hotchk155/midi_nubbin/docs/pcb.png

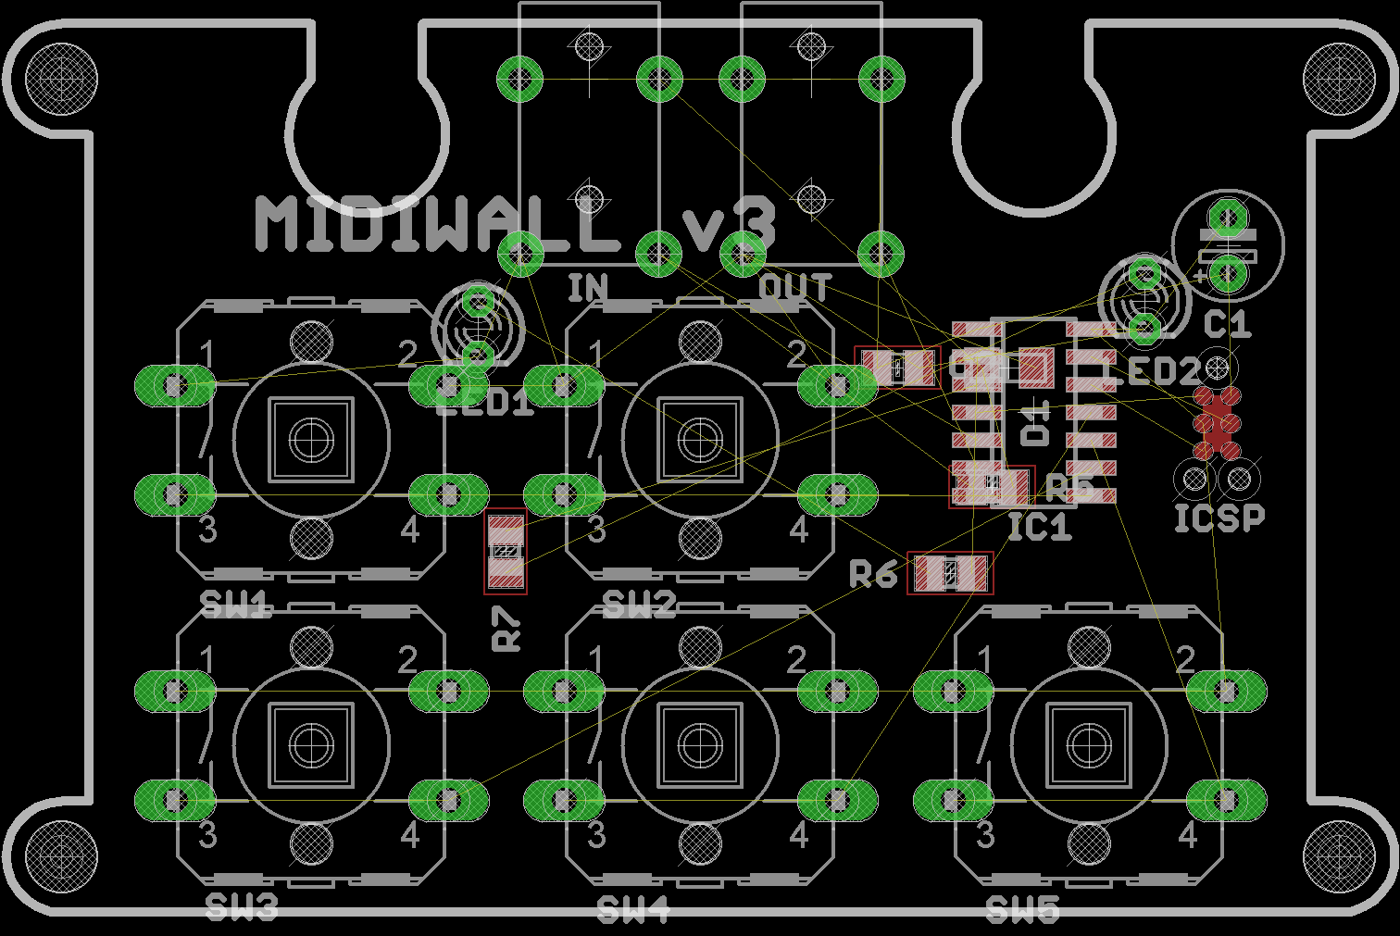
docs/pcb.png
