hotchk155/midi_nubbin/fascia/clock-fascia.png

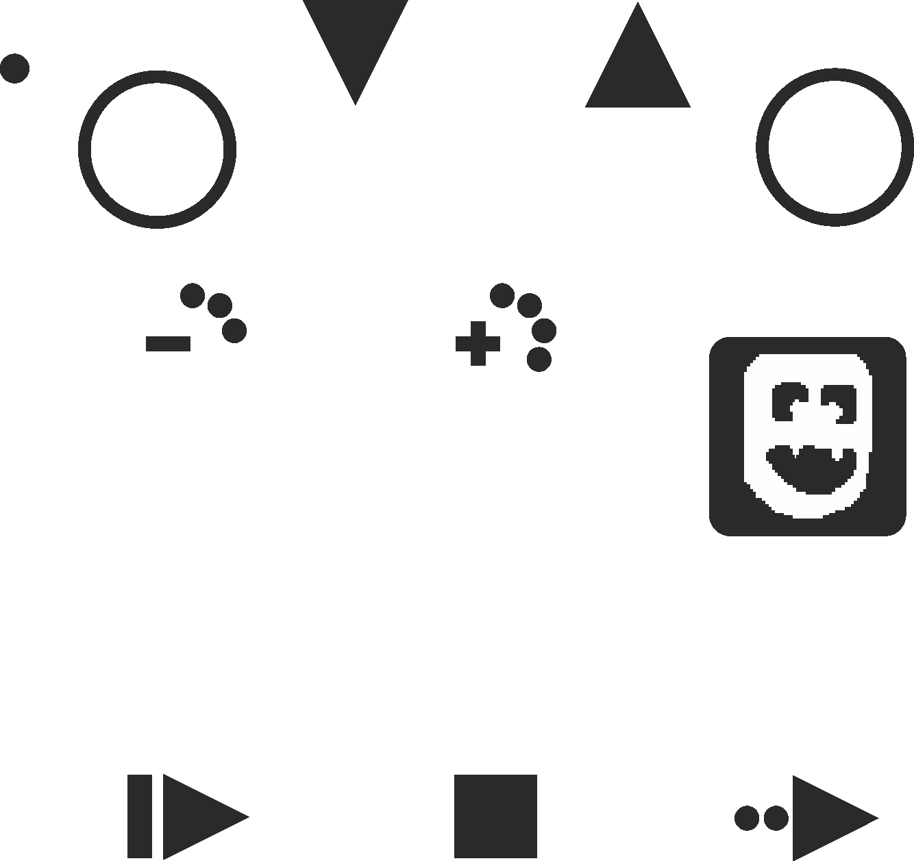
fascia/clock-fascia.png
