hotchk155/midi_nubbin/docs/MIDI Nubbin BOM.xlsx

Reflow
C1 | 10u | Tantalum Cap SMCB
C2 | 100n | Ceramic Cap 0805
D1, D2 | Blue LED | LED 0805
IC1 | PIC16F15345-I/SS | Microcontroller TSSOP20
R1, R6 | 1K | 0805 Resistor
R2, R4, R5 | 220R | 0805 Resistor
R3 | 4k7 | 0805 Resistor
Manually soldered
5 OFF | DTSM-65N-V-B | 6x6x9.5mm Tact Switch SMT
2 OFF | LUMBERG 1503 02 | Stereo 3.5mm jack SMT
8 | m3 x 6mm x 5 dia head flat head machine screw ultra low profile
5 | switch hat white
4 | 6mm f/f hex standoff
1 | white 3mm acrylic 40x48mm
1 | pcb front panel
2 | light guides 3mm dia x 4mm long
1 | 5mm EVA foam 40 x 48mm
1 | cut adhesive neoprene pad 40x48mm
1 | velcro hook pad 25x25mm
