hotchk155/midi_nubbin/hardware/midi_nubbin.brd

## EAGLE design hardware/midi_nubbin.brd (2023-05-03)

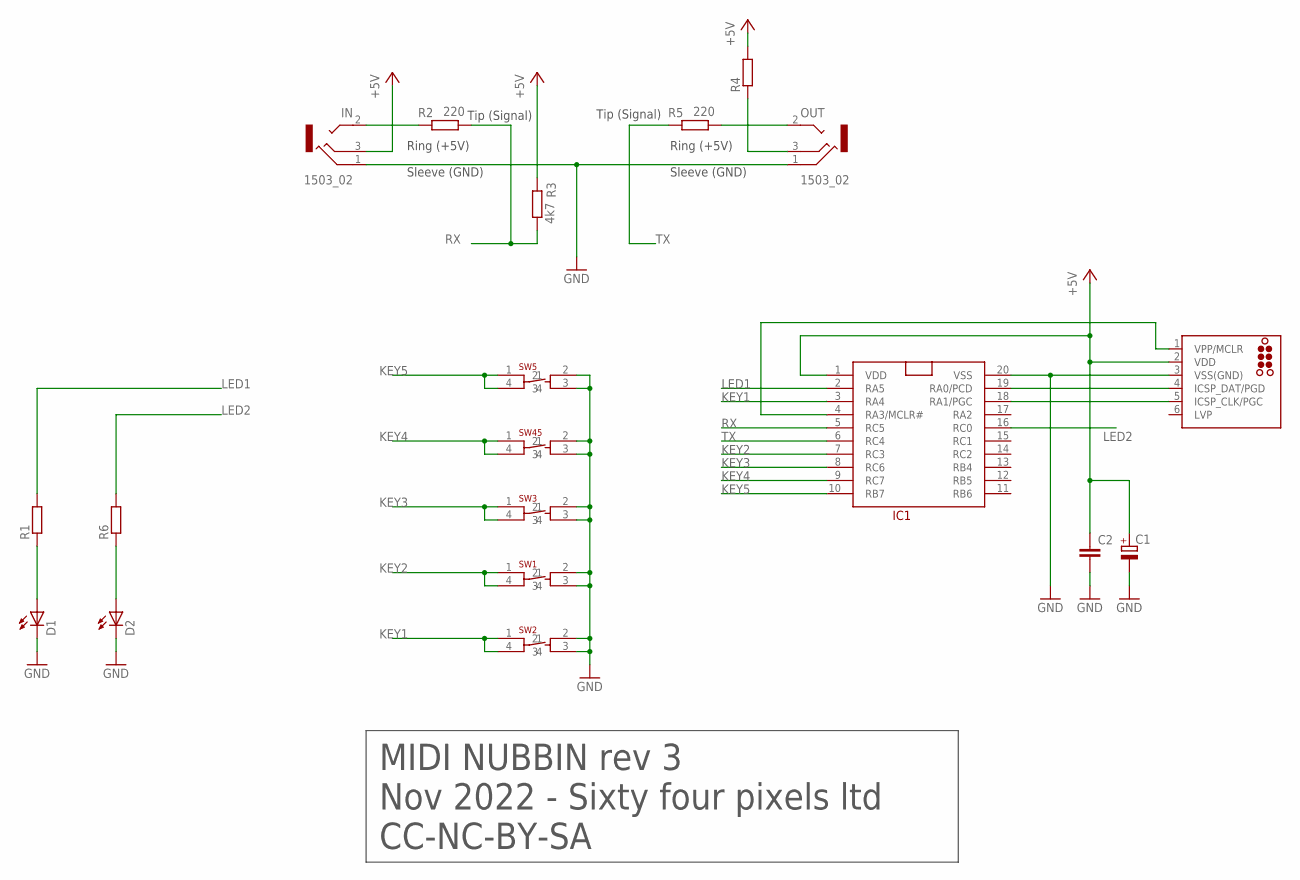
[picture p3: schematic midi_nubbin.sch]

Parts:
C1: CPOL-EUSMCB; SMC_B
C2: C-EUC0805; C0805
D1, D2: LEDCHIPLED_0805; CHIPLED_0805
IC1: PIC16F15345SSOP20; SSOP20
ICSP: TC2030-MCP-NL
IN: 1503_02
OUT: 1503_02
R1, R4, R6: R-EU_R0805; R0805
R2, R5: 220; R0805
R3: 4k7; R0805
SW1, SW2, SW3, SW5, SW45: 6MMTACTSMT

Connections:
+5V: C1.+, C2.1, IC1.1 (VDD), ICSP.2 (VDD), IN.3, R3.2, R4.2
GND: C1.-, C2.2, D1.C, D2.C, IC1.20 (VSS), ICSP.3 (VSS(GND)), IN.1, OUT.1, SW1.2, SW1.3, SW2.2, SW2.3, SW3.2, SW3.3, SW5.2, SW5.3, SW45.2, SW45.3
KEY1: IC1.3 (RA4), SW2.1, SW2.4
KEY2: IC1.7 (RC3), SW1.1, SW1.4
KEY3: IC1.8 (RC6), SW3.1, SW3.4
KEY4: IC1.9 (RC7), SW45.1, SW45.4
KEY5: IC1.10 (RB7), SW5.1, SW5.4
LED1: IC1.2 (RA5), R1.2
LED2: IC1.16 (RC0), R6.2
unnamed: D1.A, R1.1
unnamed: D2.A, R6.1
unnamed: OUT.3, R4.1
unnamed: OUT.2, R5.1
unnamed: IN.2, R2.2
PGC: IC1.18 (RA1/PGC), ICSP.5 (ICSP_CLK/PGC)
PGD: IC1.19 (RA0/PCD), ICSP.4 (ICSP_DAT/PGD)
RX: IC1.5 (RC5), R2.1, R3.1
TX: IC1.6 (RC4), R5.2
VPP: IC1.4 (RA3/MCLR#), ICSP.1 (VPP/MCLR)

Notes on the sheet:
MIDI NUBBIN rev 3
Nov 2022 - Sixty four pixels ltd
CC-NC-BY-SA
Tip (Signal)
Ring (+5V)
Sleeve (GND)

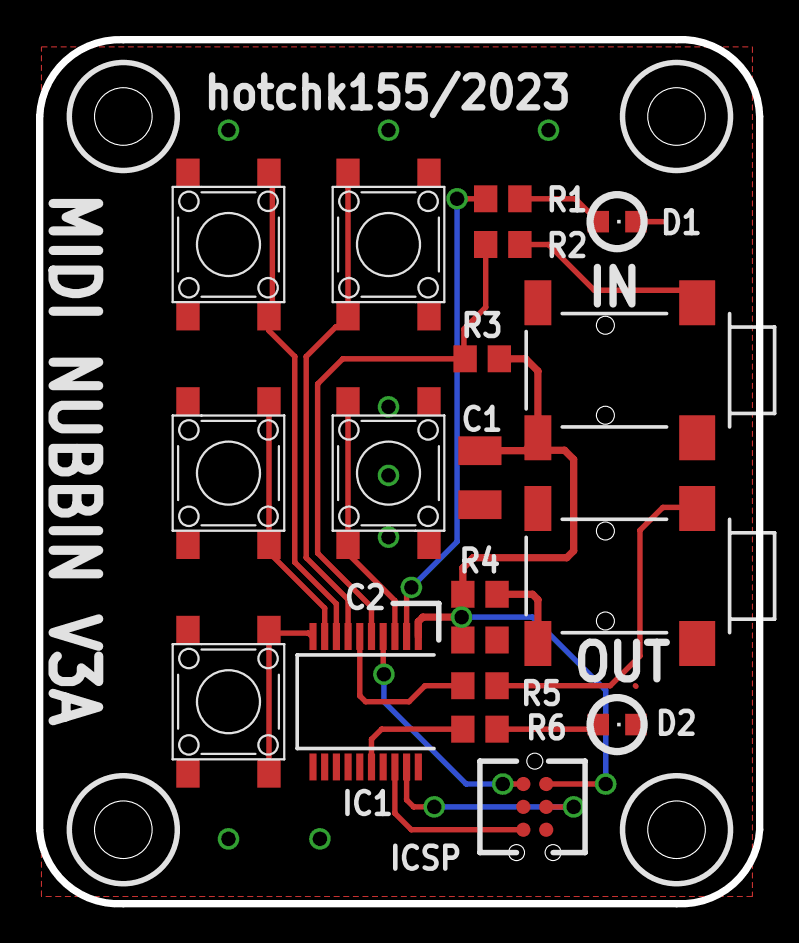
[picture p4: board midi_nubbin.brd from above]

Board: 2 copper layers, 40.0 x 48.0 mm, 19 parts (0 on the bottom side), 19 nets.
