hotchk155/midi_nubbin/hardware/midiwall.brd

## EAGLE design hardware/midiwall.brd (2022-04-05)

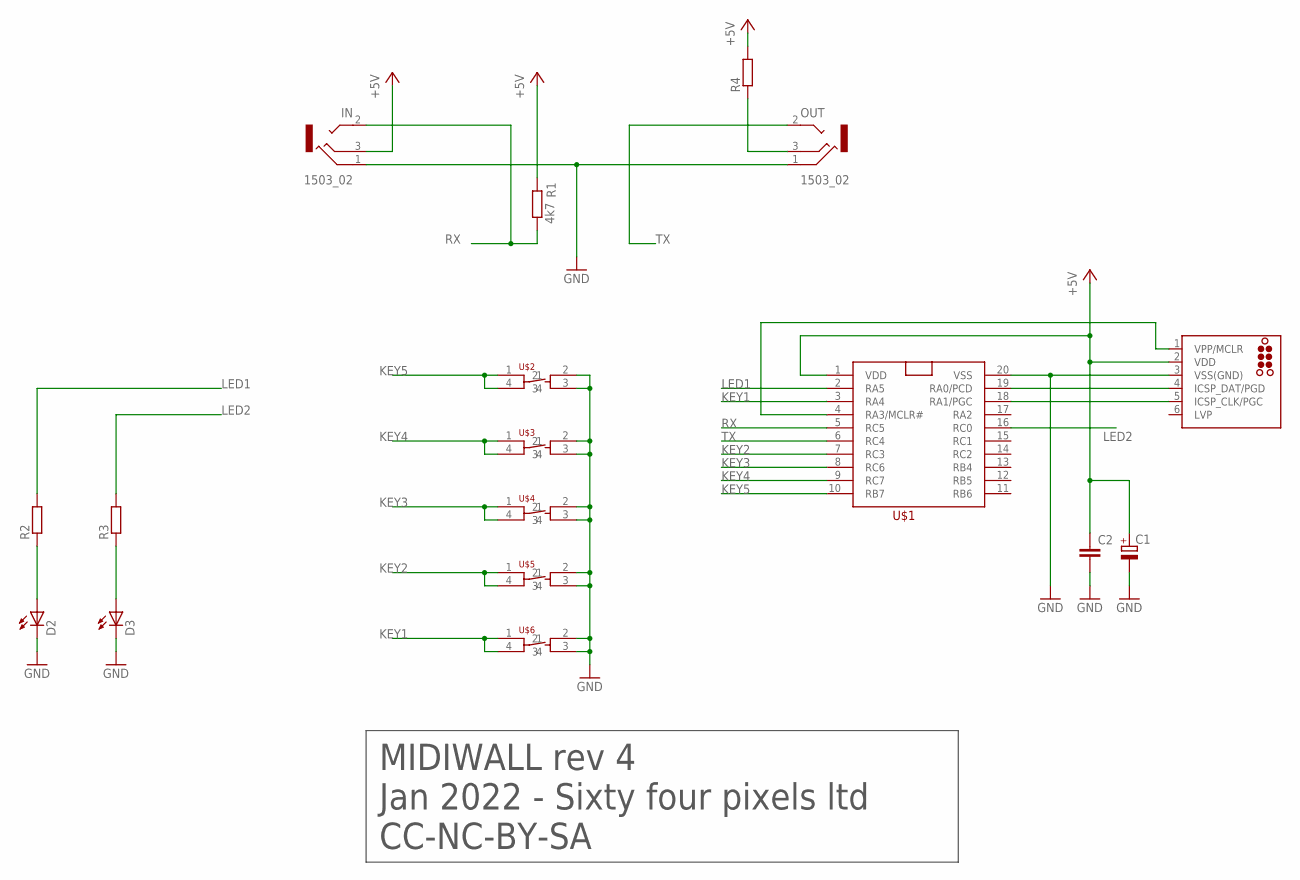
[picture p5: schematic midiwall.sch]

Parts:
C1: CPOL-EUSMCB; SMC_B
C2: C-EUC0805; C0805
D2, D3: LEDCHIPLED_0805; CHIPLED_0805
ICSP: TC2030-MCP-NL
IN: 1503_02
OUT: 1503_02
R1: 4k7; R0805
R2, R3, R4: R-EU_R0805; R0805
U$1: PIC16F15345; TSSOP20
U$2, U$3, U$4, U$5, U$6: 6MMTACTSMT

Connections:
+5V: C1.+, C2.1, ICSP.2 (VDD), IN.3, R1.2, R4.2, U$1.1 (VDD)
GND: C1.-, C2.2, D2.C, D3.C, ICSP.3 (VSS(GND)), IN.1, OUT.1, U$1.20 (VSS), U$2.2, U$2.3, U$3.2, U$3.3, U$4.2, U$4.3, U$5.2, U$5.3, U$6.2, U$6.3
KEY1: U$1.3 (RA4), U$6.1, U$6.4
KEY2: U$1.7 (RC3), U$5.1, U$5.4
KEY3: U$1.8 (RC6), U$4.1, U$4.4
KEY4: U$1.9 (RC7), U$3.1, U$3.4
KEY5: U$1.10 (RB7), U$2.1, U$2.4
LED1: R2.2, U$1.2 (RA5)
LED2: R3.2, U$1.16 (RC0)
unnamed: D2.A, R2.1
unnamed: D3.A, R3.1
unnamed: OUT.3, R4.1
PGC: ICSP.5 (ICSP_CLK/PGC), U$1.18 (RA1/PGC)
PGD: ICSP.4 (ICSP_DAT/PGD), U$1.19 (RA0/PCD)
RX: IN.2, R1.1, U$1.5 (RC5)
TX: OUT.2, U$1.6 (RC4)
VPP: ICSP.1 (VPP/MCLR), U$1.4 (RA3/MCLR#)

Notes on the sheet:
MIDIWALL rev 4
Jan 2022 - Sixty four pixels ltd
CC-NC-BY-SA

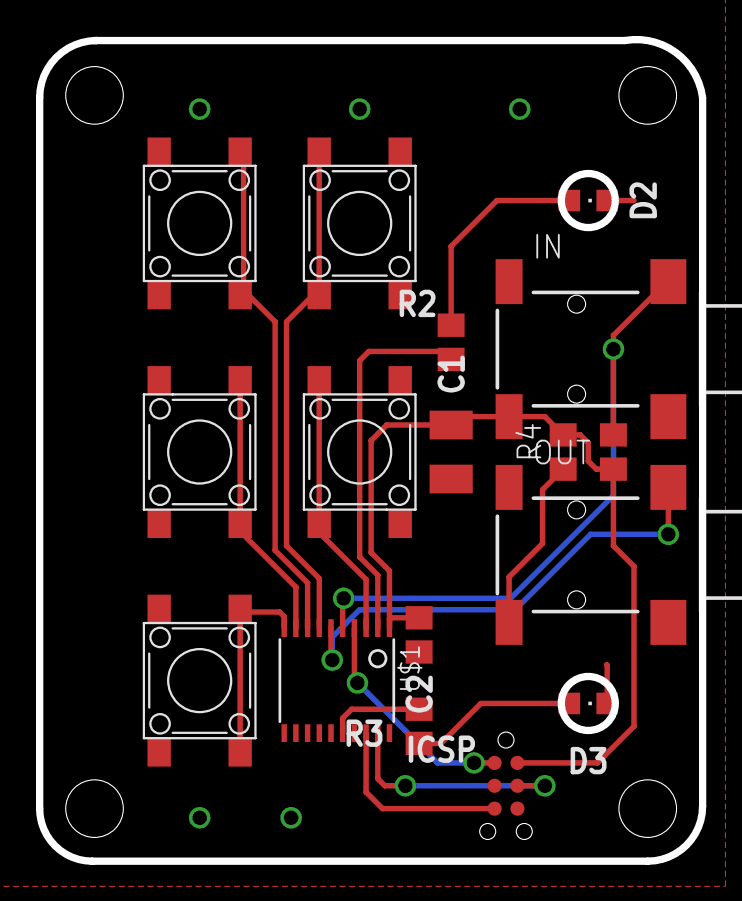
[picture p6: board midiwall.brd from above]

Board: 2 copper layers, 36.8 x 45.6 mm, 17 parts (0 on the bottom side), 17 nets.
