hotchk155/midi_nubbin/panel/midi_nubbin_panel.brd

## EAGLE design panel/midi_nubbin_panel.brd (2023-05-03)

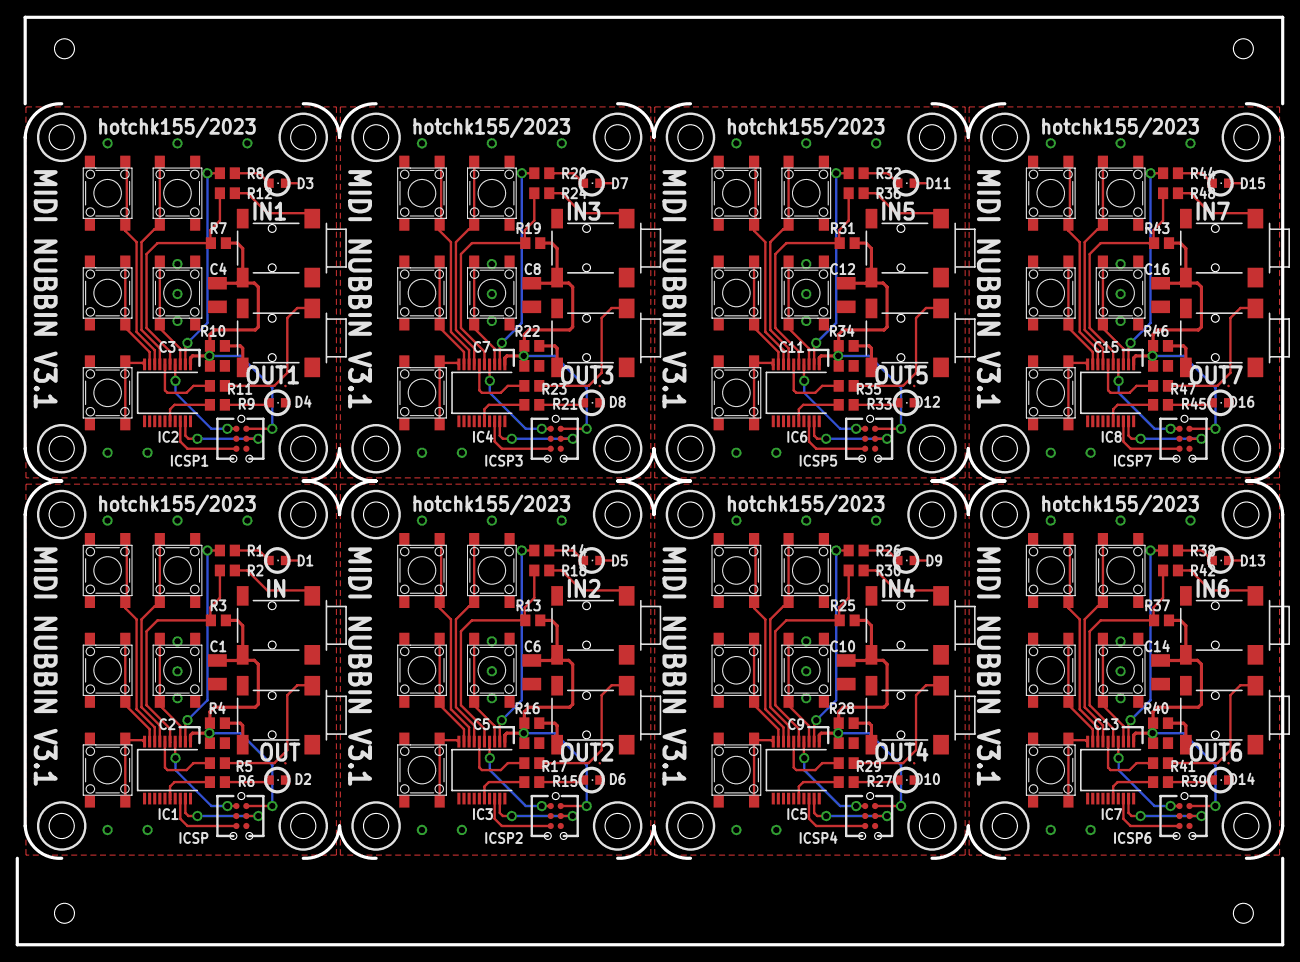
[picture p7: board midi_nubbin_panel.brd from above]

Board: 2 copper layers, 161.0 x 118.0 mm, 152 parts (0 on the bottom side), 152 nets.

Parts:
C1, C4, C6, C8, C10, C12, C14, C16: SMC_B
C2, C3, C5, C7, C9, C11, C13, C15: C0805
D1, D2, D3, D4, D5, D6, D7, D8, D9, D10, D11, D12, D13, D14, D15, D16: CHIPLED_0805
IC1, IC2, IC3, IC4, IC5, IC6, IC7, IC8: PIC16F15345SSOP20; SSOP20
ICSP, ICSP1, ICSP2, ICSP3, ICSP4, ICSP5, ICSP6, ICSP7: TC2030-MCP-NL
IN, IN1, IN2, IN3, IN4, IN5, IN6, IN7: 1503_02
OUT, OUT1, OUT2, OUT3, OUT4, OUT5, OUT6, OUT7: 1503_02
R1, R4, R6, R8, R9, R10, R14, R15, R16, R20, R21, R22, R26, R27, R28, R32, R33, R34, R38, R39, R40, R44, R45, R46: R0805
R2, R5, R11, R12, R17, R18, R23, R24, R29, R30, R35, R36, R41, R42, R47, R48: 220; R0805
R3, R7, R13, R19, R25, R31, R37, R43: 4k7; R0805
SW1, SW2, SW3, SW4, SW5, SW6, SW7, SW8, SW9, SW10, SW11, SW12, SW13, SW14, SW15, SW16, SW17, SW18, SW19, SW20, SW21, SW22, SW23, SW24, SW25, SW26, SW27, SW28, SW29, SW30, SW31, SW32, SW33, SW34, SW35, SW36, SW37, SW38, SW39, SW45: 6MMTACTSMT

Connections:
+5V: C1.+, C2.1, IC1.1, ICSP.2, IN.3, R3.2, R4.2
+5V1: C3.1, C4.+, IC2.1, ICSP1.2, IN1.3, R7.2, R10.2
+5V2: C5.1, C6.+, IC3.1, ICSP2.2, IN2.3, R13.2, R16.2
+5V3: C7.1, C8.+, IC4.1, ICSP3.2, IN3.3, R19.2, R22.2
+5V4: C9.1, C10.+, IC5.1, ICSP4.2, IN4.3, R25.2, R28.2
+5V5: C11.1, C12.+, IC6.1, ICSP5.2, IN5.3, R31.2, R34.2
+5V6: C13.1, C14.+, IC7.1, ICSP6.2, IN6.3, R37.2, R40.2
+5V7: C15.1, C16.+, IC8.1, ICSP7.2, IN7.3, R43.2, R46.2
GND: C1.-, C2.2, D1.C, D2.C, IC1.20, ICSP.3, IN.1, OUT.1, SW1.2, SW1.3, SW2.2, SW2.3, SW3.2, SW3.3, SW5.2, SW5.3, SW45.2, SW45.3
GND1: C3.2, C4.-, D3.C, D4.C, IC2.20, ICSP1.3, IN1.1, OUT1.1, SW4.2, SW4.3, SW6.2, SW6.3, SW7.2, SW7.3, SW8.2, SW8.3, SW9.2, SW9.3
GND2: C5.2, C6.-, D5.C, D6.C, IC3.20, ICSP2.3, IN2.1, OUT2.1, SW10.2, SW10.3, SW11.2, SW11.3, SW12.2, SW12.3, SW13.2, SW13.3, SW14.2, SW14.3
GND3: C7.2, C8.-, D7.C, D8.C, IC4.20, ICSP3.3, IN3.1, OUT3.1, SW15.2, SW15.3, SW16.2, SW16.3, SW17.2, SW17.3, SW18.2, SW18.3, SW19.2, SW19.3
GND4: C9.2, C10.-, D9.C, D10.C, IC5.20, ICSP4.3, IN4.1, OUT4.1, SW20.2, SW20.3, SW21.2, SW21.3, SW22.2, SW22.3, SW23.2, SW23.3, SW24.2, SW24.3
GND5: C11.2, C12.-, D11.C, D12.C, IC6.20, ICSP5.3, IN5.1, OUT5.1, SW25.2, SW25.3, SW26.2, SW26.3, SW27.2, SW27.3, SW28.2, SW28.3, SW29.2, SW29.3
GND6: C13.2, C14.-, D13.C, D14.C, IC7.20, ICSP6.3, IN6.1, OUT6.1, SW30.2, SW30.3, SW31.2, SW31.3, SW32.2, SW32.3, SW33.2, SW33.3, SW34.2, SW34.3
GND7: C15.2, C16.-, D15.C, D16.C, IC8.20, ICSP7.3, IN7.1, OUT7.1, SW35.2, SW35.3, SW36.2, SW36.3, SW37.2, SW37.3, SW38.2, SW38.3, SW39.2, SW39.3
KEY1: IC1.3, SW2.1, SW2.4
KEY2: IC1.7, SW1.1, SW1.4
KEY3: IC1.8, SW3.1, SW3.4
KEY4: IC1.9, SW45.1, SW45.4
KEY5: IC1.10, SW5.1, SW5.4
KEY6: IC2.8, SW7.1, SW7.4
KEY7: IC2.3, SW9.1, SW9.4
KEY8: IC2.7, SW8.1, SW8.4
KEY9: IC2.9, SW6.1, SW6.4
KEY10: IC2.10, SW4.1, SW4.4
KEY11: IC3.8, SW12.1, SW12.4
KEY12: IC3.3, SW14.1, SW14.4
KEY13: IC3.7, SW13.1, SW13.4
KEY14: IC3.9, SW11.1, SW11.4
KEY15: IC3.10, SW10.1, SW10.4
KEY16: IC4.8, SW17.1, SW17.4
KEY17: IC4.3, SW19.1, SW19.4
KEY18: IC4.7, SW18.1, SW18.4
KEY19: IC4.9, SW16.1, SW16.4
KEY20: IC4.10, SW15.1, SW15.4
KEY21: IC5.8, SW22.1, SW22.4
KEY22: IC5.3, SW24.1, SW24.4
KEY23: IC5.7, SW23.1, SW23.4
KEY24: IC5.9, SW21.1, SW21.4
KEY25: IC5.10, SW20.1, SW20.4
KEY26: IC6.8, SW27.1, SW27.4
KEY27: IC6.3, SW29.1, SW29.4
KEY28: IC6.7, SW28.1, SW28.4
KEY29: IC6.9, SW26.1, SW26.4
KEY30: IC6.10, SW25.1, SW25.4
KEY31: IC7.8, SW32.1, SW32.4
KEY32: IC7.3, SW34.1, SW34.4
KEY33: IC7.7, SW33.1, SW33.4
KEY34: IC7.9, SW31.1, SW31.4
KEY35: IC7.10, SW30.1, SW30.4
KEY36: IC8.8, SW37.1, SW37.4
KEY37: IC8.3, SW39.1, SW39.4
KEY38: IC8.7, SW38.1, SW38.4
KEY39: IC8.9, SW36.1, SW36.4
KEY40: IC8.10, SW35.1, SW35.4
LED1: IC1.2, R1.2
LED2: IC1.16, R6.2
LED3: IC2.2, R8.2
LED4: IC2.16, R9.2
LED5: IC3.2, R14.2
LED6: IC3.16, R15.2
LED7: IC4.2, R20.2
LED8: IC4.16, R21.2
LED9: IC5.2, R26.2
LED10: IC5.16, R27.2
LED11: IC6.2, R32.2
LED12: IC6.16, R33.2
LED13: IC7.2, R38.2
LED14: IC7.16, R39.2
LED15: IC8.2, R44.2
LED16: IC8.16, R45.2
unnamed: D1.A, R1.1
unnamed: D2.A, R6.1
unnamed: OUT.3, R4.1
unnamed: OUT.2, R5.1
unnamed: IN.2, R2.2
unnamed: D3.A, R8.1
unnamed: D4.A, R9.1
unnamed: OUT1.3, R10.1
unnamed: OUT1.2, R11.1
unnamed: IN1.2, R12.2
unnamed: D5.A, R14.1
unnamed: D6.A, R15.1
unnamed: OUT2.3, R16.1
unnamed: OUT2.2, R17.1
unnamed: IN2.2, R18.2
unnamed: D7.A, R20.1
unnamed: D8.A, R21.1
unnamed: OUT3.3, R22.1
unnamed: OUT3.2, R23.1
unnamed: IN3.2, R24.2
unnamed: D9.A, R26.1
unnamed: D10.A, R27.1
unnamed: OUT4.3, R28.1
unnamed: OUT4.2, R29.1
unnamed: IN4.2, R30.2
unnamed: D11.A, R32.1
unnamed: D12.A, R33.1
unnamed: OUT5.3, R34.1
unnamed: OUT5.2, R35.1
unnamed: IN5.2, R36.2
unnamed: D13.A, R38.1
unnamed: D14.A, R39.1
unnamed: OUT6.3, R40.1
unnamed: OUT6.2, R41.1
unnamed: IN6.2, R42.2
unnamed: D15.A, R44.1
unnamed: D16.A, R45.1
unnamed: OUT7.3, R46.1
unnamed: OUT7.2, R47.1
unnamed: IN7.2, R48.2
PGC: IC1.18, ICSP.5
PGC1: IC2.18, ICSP1.5
PGC2: IC3.18, ICSP2.5
PGC3: IC4.18, ICSP3.5
PGC4: IC5.18, ICSP4.5
PGC5: IC6.18, ICSP5.5
PGC6: IC7.18, ICSP6.5
PGC7: IC8.18, ICSP7.5
PGD: IC1.19, ICSP.4
PGD1: IC2.19, ICSP1.4
PGD2: IC3.19, ICSP2.4
PGD3: IC4.19, ICSP3.4
PGD4: IC5.19, ICSP4.4
PGD5: IC6.19, ICSP5.4
PGD6: IC7.19, ICSP6.4
PGD7: IC8.19, ICSP7.4
RX: IC1.5, R2.1, R3.1
RX1: IC2.5, R7.1, R12.1
RX2: IC3.5, R13.1, R18.1
RX3: IC4.5, R19.1, R24.1
RX4: IC5.5, R25.1, R30.1
RX5: IC6.5, R31.1, R36.1
RX6: IC7.5, R37.1, R42.1
RX7: IC8.5, R43.1, R48.1
TX: IC1.6, R5.2
TX1: IC2.6, R11.2
TX2: IC3.6, R17.2
TX3: IC4.6, R23.2
TX4: IC5.6, R29.2
TX5: IC6.6, R35.2
TX6: IC7.6, R41.2
TX7: IC8.6, R47.2
VPP: IC1.4, ICSP.1
VPP1: IC2.4, ICSP1.1
VPP2: IC3.4, ICSP2.1
VPP3: IC4.4, ICSP3.1
VPP4: IC5.4, ICSP4.1
VPP5: IC6.4, ICSP5.1
VPP6: IC7.4, ICSP6.1
VPP7: IC8.4, ICSP7.1
