hotchk155/midi_nubbin/firmware.X/main.c

////////////////////////////////////////////////////////////////////////////////
//
// M I D I   N U B B I N 
//
////////////////////////////////////////////////////////////////////////////////

/*
 
       PIC16F15345
 
        VDD | VSS
LED1    RA5 | RA0
KEY1    RA4 | RA1
        RA3 | RA2
RX      RC5 | RC0       LED2
TX      RC4 | RC1
KEY2    RC3 | RC2 
KEY3    RC6 | RB4
KEY4    RC7 | RB5   
KEY5    RB7 | RB6
 
 */
// COMPILER SETTINGS
// Memory Model
//      - ROM Ranges: default,-1F80-1FFF

// PIC16F15345 Configuration Bit Settings
// 'C' source line config statements
// CONFIG1
#pragma config FEXTOSC = OFF    // External Oscillator mode selection bits (Oscillator not enabled)
#pragma config RSTOSC = HFINTPLL// Power-up default value for COSC bits (HFINTOSC with 2x PLL, with OSCFRQ = 16 MHz and CDIV = 1:1 (FOSC = 32 MHz))
#pragma config CLKOUTEN = OFF   // Clock Out Enable bit (CLKOUT function is disabled; i/o or oscillator function on OSC2)
#pragma config CSWEN = ON       // Clock Switch Enable bit (Writing to NOSC and NDIV is allowed)
#pragma config FCMEN = ON       // Fail-Safe Clock Monitor Enable bit (FSCM timer enabled)

// CONFIG2
#pragma config MCLRE = OFF      // Master Clear Enable bit (MCLR pin function is port defined function)
#pragma config PWRTE = OFF      // Power-up Timer Enable bit (PWRT disabled)
#pragma config LPBOREN = OFF    // Low-Power BOR enable bit (ULPBOR disabled)
#pragma config BOREN = ON       // Brown-out reset enable bits (Brown-out Reset Enabled, SBOREN bit is ignored)
#pragma config BORV = LO        // Brown-out Reset Voltage Selection (Brown-out Reset Voltage (VBOR) set to 1.9V on LF, and 2.45V on F Devices)
#pragma config ZCD = OFF        // Zero-cross detect disable (Zero-cross detect circuit is disabled at POR.)
#pragma config PPS1WAY = ON     // Peripheral Pin Select one-way control (The PPSLOCK bit can be cleared and set only once in software)
#pragma config STVREN = ON      // Stack Overflow/Underflow Reset Enable bit (Stack Overflow or Underflow will cause a reset)

// CONFIG3
#pragma config WDTCPS = WDTCPS_31// WDT Period Select bits (Divider ratio 1:65536; software control of WDTPS)
#pragma config WDTE = OFF        // WDT operating mode (WDT enabled regardless of sleep; SWDTEN ignored)
#pragma config WDTCWS = WDTCWS_7// WDT Window Select bits (window always open (100%); software control; keyed access not required)
#pragma config WDTCCS = SC      // WDT input clock selector (Software Control)

// CONFIG4
#pragma config BBSIZE = BB512   // Boot Block Size Selection bits (512 words boot block size)
#pragma config BBEN = OFF       // Boot Block Enable bit (Boot Block disabled)
#pragma config SAFEN = ON       // SAF Enable bit 
#pragma config WRTAPP = OFF     // Application Block Write Protection bit (Application Block not write protected)
#pragma config WRTB = OFF       // Boot Block Write Protection bit (Boot Block not write protected)
#pragma config WRTC = OFF       // Configuration Register Write Protection bit (Configuration Register not write protected)
#pragma config WRTSAF = OFF     // Storage Area Flash Write Protection bit (SAF not write protected)
#pragma config LVP = OFF        // Low Voltage Programming Enable bit (High Voltage on MCLR/Vpp must be used for programming)

// CONFIG5
#pragma config CP = OFF         // UserNVM Program memory code protection bit (UserNVM code protection disabled)

// #pragma config statements should precede project file includes.
// Use project enums instead of #define for ON and OFF.

#include <xc.h>
#include "mn.h"

MNApp g_app;
PRIVATE void app_key_event(byte event, byte keys){    
    // empty
}
PRIVATE void app_midi_realtime(byte data) {
    // pass through
    mn_send_midi_realtime(data);
}
PRIVATE void app_midi_msg(byte status, byte num_params, byte param1, byte param2) {
    // pass through
    mn_send_midi_msg(status, num_params, param1, param2);
}
PRIVATE void app_tick(void) { 
    // empty
}
PRIVATE void app_run(void) {   
    // empty
}

void main(void) {    
    // initialise default handlers
    g_app.app_key_event = app_key_event;
    g_app.app_midi_realtime = app_midi_realtime;
    g_app.app_midi_msg = app_midi_msg;
    g_app.app_tick = app_tick;
    g_app.app_run = app_run;      
    
    // initialise the basics
    mn_init();

    // initialise the utils
    mn_utils_reset();
    
    
    // initialise the specific app to run
    app_init_pitchslap();
    //app_init_da_chord();
    for(;;) {
        // run the application
        mn_run();
    }
}
