hotchk155/midi_nubbin/(commit log)

2019-06-30 v2 poss
    [midiwall.brd, midiwall.sch]
2019-09-30 new case
    [midiwall.brd, midiwall.sch]
2022-01-11 Version 4 PCB PROD
    [midiwall.brd, midiwall.sch]
2022-04-06 MN V1 PCB?
    [midi_nubbin.brd, midi_nubbin.sch]
2022-08-08 Change SSOP footprint
    [midi_nubbin.brd, midi_nubbin.sch]
2022-08-08 BOARD V2
    [midi_nubbin.brd, midi_nubbin.sch]
2022-10-07 mcu change
    [midi_nubbin.sch]
2022-11-25 add logo
    [midi_nubbin.brd]
2022-11-25 panelize, stencil, fascia
    [midi_nubbin_fascia.kicad_pcb, midi_nubbin_fascia.kicad_sch, midi_nubbin_stencil.brd]
2023-05-03 V3.1 increase min via hole size
    [midi_nubbin.brd]
2023-05-03 panelised 3.1
    [midi_nubbin_panel.brd]
2024-10-25 add generic fasica
    [midi_nubbin_fascia.kicad_pcb]
2024-10-25 adding generic fascia
    [midi_nubbin_fascia.kicad_pcb]
2024-11-18 fascia v2
    [MIDI Nubbin BOM.xlsx, midi_nubbin_fascia.kicad_sch]
2024-12-05 add test firmware
    [MIDI Nubbin BOM.xlsx]
